pschake34/WeatherCollector/images/finished_enclosure_battery.jpg

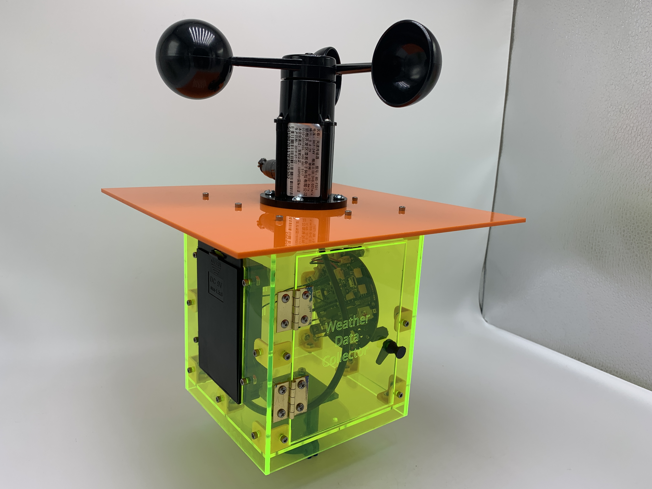
images/finished_enclosure_battery.jpg
