pschake34/WeatherCollector/images/Weather Data Collector iteration (Door).jpg

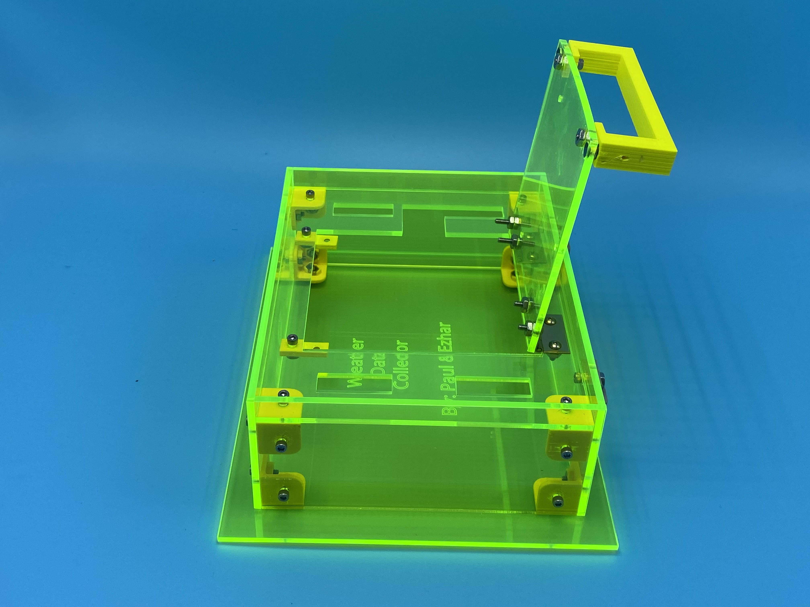
images/Weather Data Collector iteration (Door).jpg
