pschake34/WeatherCollector/images/Weather Data Collector iteration (Wind Gauge plate).PNG

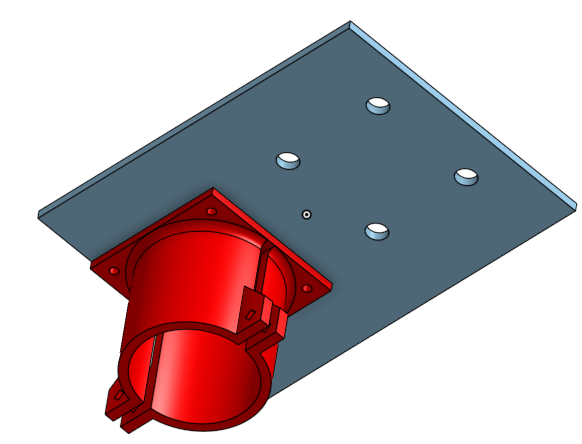
images/Weather Data Collector iteration (Wind Gauge plate).PNG
