pschake34/WeatherCollector/images/Weather Data Collector iteration (wind gauge top).jpg

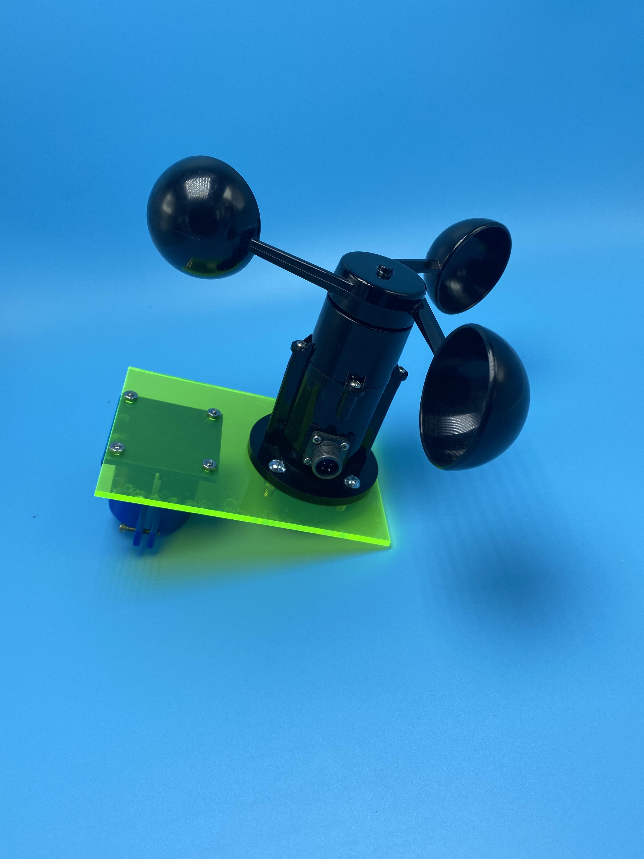
images/Weather Data Collector iteration (wind gauge top).jpg
