pschake34/WeatherCollector/images/Weather Data Collector iteration (wind gauge).jpg

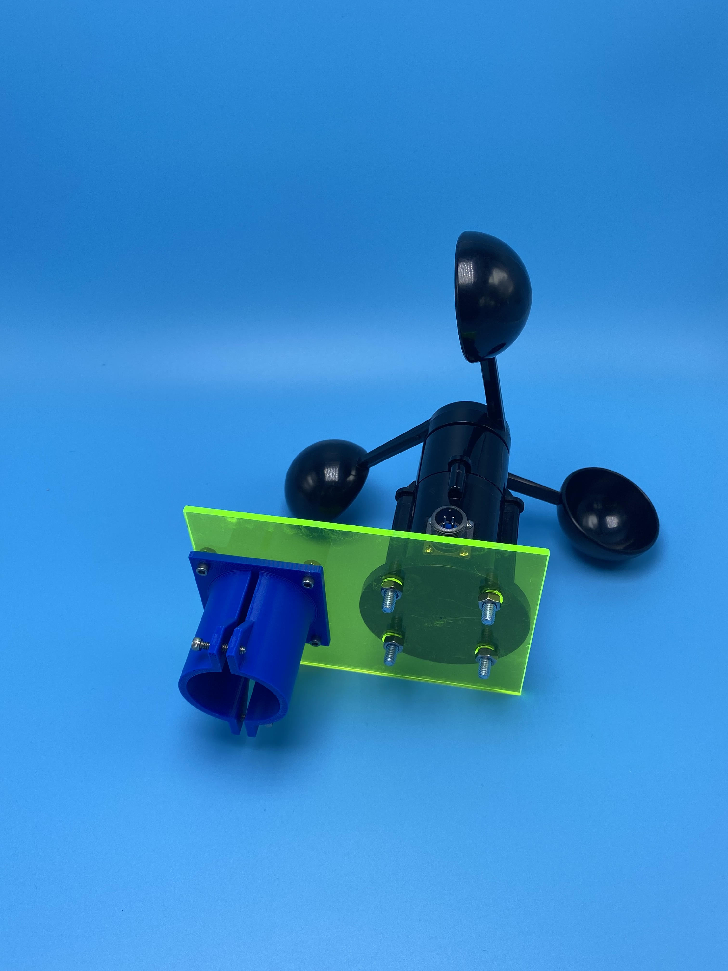
images/Weather Data Collector iteration (wind gauge).jpg
