pschake34/WeatherCollector/images/Weather Data Collector iteration.PNG

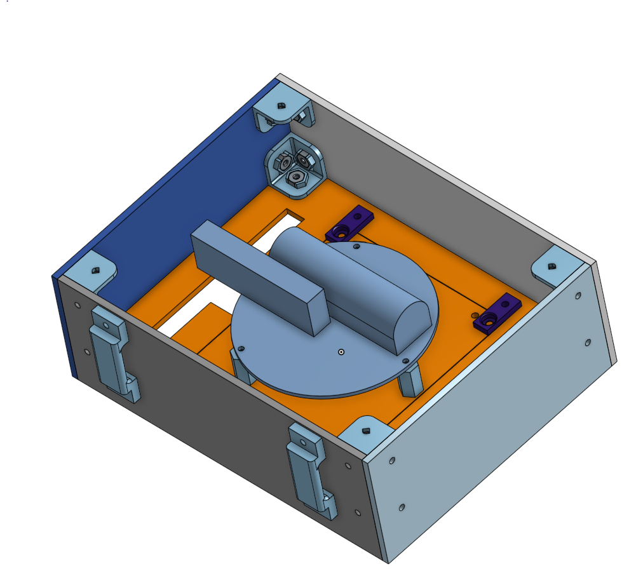
images/Weather Data Collector iteration.PNG
