pschake34/WeatherCollector/prototypes/wifi_connection/SSID_info_TEMPLATE.h

// Paul Schakel
// SSID_info.h
// Contains password information for connecting to Network

const char SSID[] = "SSID";   // your network SSID (name)
const char PASSWORD[] = "PASSWORD";   // your network password (use for WPA, or use as key for WEP)
