pschake34/WeatherCollector/(commit log)

2021-12-15 Create initial prototype of wind speed sensor
2021-12-15 Create initial prototype of Pressure and Temperature
2021-12-29 Add prototype for humidity and temperature
2021-12-29 Add basic prototype testing MKR IoT carrier display and buttons
2022-01-04 Add prototype for connecting to WiFi with MKR 1010
2022-01-20 Change pressure units to inHg and try to calibrate temperature
2022-01-26 Change code folder to arduino_code
2022-01-31 Complete table of sensor research and arduino wireless communication
2022-02-04 Add responsiveness and a temperature gauge
2022-02-07 Start figuring out positioning for temperature guage indicator
2022-02-07 Change colors of temperature guage
2022-02-09 Make changes to compute coordinates for temperature guage
2022-02-10 Add a couple comments
2022-02-10 Almost finish temperature guage coordinates and angle computation
2022-02-11 Pretty much finish temperature guage positioning, and tweak some styling
2022-02-11 Add more items to table of contents, add overview and code prototypes
2022-02-14 Add functionality for getting data from webhooks and celcius temperatures
2022-02-14 Add webhook functionality to other data and convert pressure to metric
2022-02-23 Remove outdated pressure sensor code
2022-02-23 Create framework for graphs page
2022-02-23 Add buttons for datatypes and support for active buttons
2022-02-23 Add styling for datatype buttons and clean up graphs design
2022-02-25 Calibrate wind speed prototype
2022-02-25 Add anemometer to arduino code
2022-02-28 Fix a couple of problems with css
2022-02-28 Finish initial design section and exposition of Arduino Code
2022-02-28 Add some more to Final Arduino Code
2022-03-07 CAD documentation
2022-03-07 CAD DOC.
2022-03-15 Add description and section to CAD
2022-03-22 Finish reflection for final arduino code and start web dashboard
2022-03-23 CAD reflection
2022-03-25 Weather box images CAD
2022-03-25 Add images of CAD and write some of Final Results
2022-05-18 Add post request prototype
2022-05-25 Finish post request prototype
2022-06-01 Add prototype for rtc
2022-06-03 Finish RTC prototype
2022-06-09 Adding CAD iteration images
